cmdc0de/yet-another-processor/docs/compiler-rust/features.md

# Rust compiler features

Prefix: `COMPILER-RUST`

Higher-level language → YAP1. Output must run on `yap-emu`. Not LLVM. Not GCC. Not the Python assembler (`docs/compiler/`).

Implementation: `compiler/rust/`. Tests under `compiler/tests/` and/or that crate. v1 is **Linux**. Language shape and YAP1 layout are `design.md` after this catalog.

## Tree and host

| ID | Feature | Status | Milestone |
|----|---|---|---|
| COMPILER-RUST-001 | ~~Sources under `compiler/rust/`~~ | done | m1 |
| COMPILER-RUST-002 | ~~Build and tests run on Linux (dev host)~~ | done | m1 |
| COMPILER-RUST-003 | ~~Tests fail if `cargo` / `rustc` is missing~~ | done | m1 |

## Image and CLI

| ID | Feature | Status | Milestone |
|----|---|---|---|
| COMPILER-RUST-004 | ~~CLI: input path and `-o` YAP1 output~~ | done | m1 |
| COMPILER-RUST-005 | ~~Emits a valid YAP1 (same 16-byte header as the Python assembler)~~ | done | m1 |

## Language

| ID | Feature | Status | Milestone |
|----|---|---|---|
| COMPILER-RUST-006 | ~~Documented source language (`design.md`)~~ | done | m1 |
| COMPILER-RUST-007 | ~~Integer literals and add/sub in that language~~ | done | m2 |
| COMPILER-RUST-008 | ~~One entry function compiled to reset `PC=0` (or documented entry)~~ | done | m1 |
| COMPILER-RUST-009 | ~~Call/return using the ISA ABI (`sp`, `ra`, args)~~ | done | m2 |

## Run

| ID | Feature | Status | Milestone |
|----|---|---|---|
| COMPILER-RUST-010 | ~~A compiled program reaches `halt` on `yap-emu` (exit 0)~~ | done | m1 |

## Later generation (do not pull into m1)

| ID | Feature | Status | Milestone |
|----|---|---|---|
| COMPILER-RUST-011 | Multi-file programs / linking | open | later-generation |
| COMPILER-RUST-012 | C language frontend | open | later-generation |
| COMPILER-RUST-013 | Floating-point in the source language | open | later-generation |
