cmdc0de/yet-another-processor/docs/footprints-and-models/3d/IRLML6401TRPBF.step

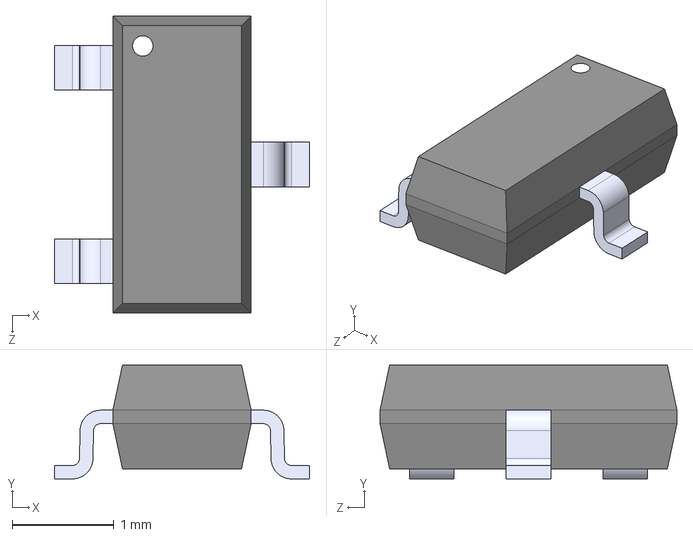
[picture p1: CAD file, 2025-11-29]
docs/footprints-and-models/3d/IRLML6401TRPBF.step
2.51 x 1.12 x 2.92 mm
