cmdc0de/yet-another-processor/docs/footprints-and-models/Fusion360/MICRO3_SOT23_INF.step

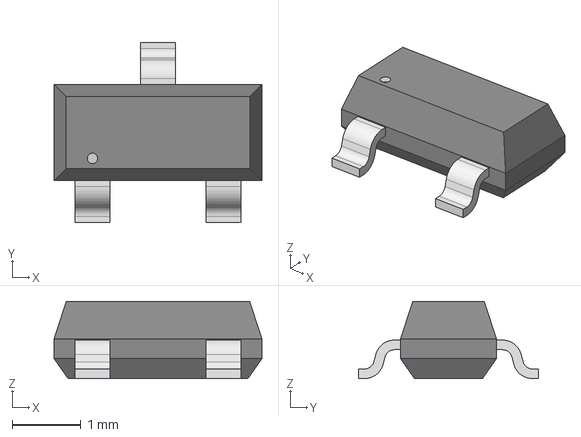
[picture p2: CAD file, 2025-11-29]
docs/footprints-and-models/Fusion360/MICRO3_SOT23_INF.step
3.02 x 2.62 x 1.12 mm
