cmdc0de/yet-another-processor/docs/footprints-and-models/3d/MAX4610CSD_T.step

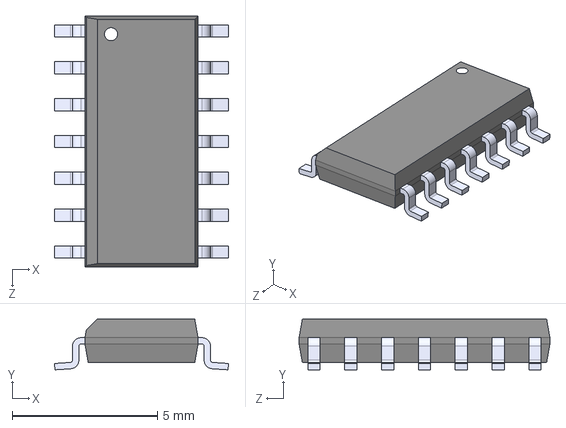
[picture p3: CAD file, 2025-11-29]
docs/footprints-and-models/3d/MAX4610CSD_T.step
6.00 x 1.75 x 8.65 mm
