cmdc0de/yet-another-processor/docs/physical-cpu/milestones/m11-testplan.md

# physical-cpu m11 testplan

One acceptance check per claimed feature. Walkthrough commands are written by `/implement-m`.

| ID | Check |
|----|---|
| PHYSICAL-CPU-016 | `hw/latch/` contains a `.kicad_pcb`. File text names `IRLML6246`, `IRLML6401`, `MICRO3_SOT23_INF`, and nets `D`, `EN`, `Q`, `VDD`, `VSS`. m1 latch tests still pass. |
