cmdc0de/yet-another-processor/lt-spice/and1_test.asc

U1: and1
V1: voltage; 3.3
V2: voltage; PULSE(0 3.3 45u 5u 5u 45u 100u 2)
V3: voltage; PULSE(0 3.3 95u 5u 5u 100u 200u 1)
Named nets: 0, vdd, a, b, and_out
.tran 200u
