cmdc0de/yet-another-processor/lt-spice/inverter_test.asc

V1: voltage; 3.3
V2: voltage; PULSE(0 3.3 50u 5u 5u 50u 100u 2)
X1: inverter; ""
Named nets: 0, in, out
.tran 200u
