cmdc0de/yet-another-processor/lt-spice/nand_test.asc

V1: voltage; 3.3
V2: voltage; PULSE(0 3.3 95u 5u 5u 100u 200u 2)
V3: voltage; PULSE(0 3.3 45u 5u 5u 45u 100u 2)
X1: nand
Named nets: 0, VDD, A, B, Y
.tran 200u
