cmdc0de/yet-another-processor/lt-spice/nor_test.asc

V1: voltage; 3.3
V2: voltage; PULSE(0 3.3 50u 5u 5u 50u 100u 2)
V3: voltage; PULSE(0 3.3 100u 5u 5u 100u 200u 1)
X1: nor
Named nets: 0, VDD, a, b, y
.inc ltspice_cmdc0de.lib
.tran 200u
