cmdc0de/yet-another-processor/hw/memport/memport_test.cir

YAP CPU memory port LAT_MEM=1 PHYSICAL-CPU-014
* Behavioral 32-bit word at addr 0. we+clk samples wdata; re drives rdata.
.subckt MEMBIT d we q vdd gnd
S1 d q we 0 icwe
Cq q 0 1n
Rq q 0 1T
.model icwe SW(vt=1.65 vh=0.4 ron=1 roff=1T)
.ends MEMBIT
VDD VDD 0 DC 3.3
VVSS VSS 0 DC 0
Vclk clk 0 PWL(0 0 50u 0 52u 3.3 80u 3.3 82u 0 150u 0)
Vwe we 0 PWL(0 3.3 80u 3.3 82u 0 150u 0)
Vre re 0 PWL(0 0 90u 0 92u 3.3 150u 3.3)
Vsz0 sz0 0 DC 0
Vsz1 sz1 0 DC 3.3
Vw0 wdata0 0 DC 3.3
Vw1 wdata1 0 DC 0
Vw2 wdata2 0 DC 0
Vw3 wdata3 0 DC 0
Vw4 wdata4 0 DC 0
Vw5 wdata5 0 DC 0
Vw6 wdata6 0 DC 0
Vw7 wdata7 0 DC 0
Vw8 wdata8 0 DC 0
Vw9 wdata9 0 DC 0
Vw10 wdata10 0 DC 0
Vw11 wdata11 0 DC 0
Vw12 wdata12 0 DC 0
Vw13 wdata13 0 DC 0
Vw14 wdata14 0 DC 0
Vw15 wdata15 0 DC 0
Vw16 wdata16 0 DC 0
Vw17 wdata17 0 DC 0
Vw18 wdata18 0 DC 0
Vw19 wdata19 0 DC 0
Vw20 wdata20 0 DC 0
Vw21 wdata21 0 DC 0
Vw22 wdata22 0 DC 0
Vw23 wdata23 0 DC 0
Vw24 wdata24 0 DC 0
Vw25 wdata25 0 DC 0
Vw26 wdata26 0 DC 0
Vw27 wdata27 0 DC 0
Vw28 wdata28 0 DC 0
Vw29 wdata29 0 DC 0
Vw30 wdata30 0 DC 0
Vw31 wdata31 0 DC 0
Va0 addr0 0 DC 0
Va1 addr1 0 DC 0
Va2 addr2 0 DC 0
Va3 addr3 0 DC 0
Va4 addr4 0 DC 0
Va5 addr5 0 DC 0
Va6 addr6 0 DC 0
Va7 addr7 0 DC 0
Va8 addr8 0 DC 0
Va9 addr9 0 DC 0
Va10 addr10 0 DC 0
Va11 addr11 0 DC 0
Va12 addr12 0 DC 0
Va13 addr13 0 DC 0
Va14 addr14 0 DC 0
Va15 addr15 0 DC 0
Va16 addr16 0 DC 0
Va17 addr17 0 DC 0
Va18 addr18 0 DC 0
Va19 addr19 0 DC 0
Va20 addr20 0 DC 0
Va21 addr21 0 DC 0
Va22 addr22 0 DC 0
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
Br30 rdata30 0 V={v(re)>1.65 ? v(m30) : 0}
Xm31 wdata31 weclk m31 VDD VSS MEMBIT
Br31 rdata31 0 V={v(re)>1.65 ? v(m31) : 0}
.ic v(m0)=0 v(m1)=0
.tran 1u 150u uic
.control
set filetype=ascii
run
meas tran r0 FIND v(rdata0) AT=120u
meas tran r1 FIND v(rdata1) AT=120u
.endc
.end
