cmdc0de/yet-another-processor/hw/ucode/ucode_test.cir

YAP microcode ROM 256x64 and uPC PHYSICAL-CPU-013
* Behavioral IC ROM + 8-bit uPC. seq=NEXT (0) increments. Not MOSFET storage.
.subckt UPCBIT d we q vdd gnd
S1 d q we 0 icwe
Cq q 0 10p
Rq q 0 1T
.model icwe SW(vt=1.65 vh=0.4 ron=1 roff=1T)
.ends UPCBIT
VDD VDD 0 DC 3.3
VVSS VSS 0 DC 0
Vclk clk 0 PWL(0 0 50u 0 52u 3.3 80u 3.3 82u 0 150u 0)
Bclkn clkn 0 V={v(clk)>1.65 ? 0 : 3.3}
Xm0 next0 clkn m0 VDD VSS UPCBIT
Cm0 m0 0 1n
Xs0 m0 clk upc0 VDD VSS UPCBIT
Xm1 next1 clkn m1 VDD VSS UPCBIT
Cm1 m1 0 1n
Xs1 m1 clk upc1 VDD VSS UPCBIT
Xm2 next2 clkn m2 VDD VSS UPCBIT
Cm2 m2 0 1n
Xs2 m2 clk upc2 VDD VSS UPCBIT
Xm3 next3 clkn m3 VDD VSS UPCBIT
Cm3 m3 0 1n
Xs3 m3 clk upc3 VDD VSS UPCBIT
Xm4 next4 clkn m4 VDD VSS UPCBIT
Cm4 m4 0 1n
Xs4 m4 clk upc4 VDD VSS UPCBIT
Xm5 next5 clkn m5 VDD VSS UPCBIT
Cm5 m5 0 1n
Xs5 m5 clk upc5 VDD VSS UPCBIT
Xm6 next6 clkn m6 VDD VSS UPCBIT
Cm6 m6 0 1n
Xs6 m6 clk upc6 VDD VSS UPCBIT
Xm7 next7 clkn m7 VDD VSS UPCBIT
Cm7 m7 0 1n
Xs7 m7 clk upc7 VDD VSS UPCBIT
Bisnxt isnxt 0 V={u(1.65-v(cw0))*u(1.65-v(cw1))*u(1.65-v(cw2))*3.3}
Bcin0 cin0 0 V=v(isnxt)
Bnext0 next0 0 V={(v(upc0)>1.65) ? ((v(cin0)>1.65) ? 0 : 3.3) : ((v(cin0)>1.65) ? 3.3 : 0)}
Bcin1 cin1 0 V={((v(upc0)>1.65) && (v(cin0)>1.65)) ? 3.3 : 0}
Bnext1 next1 0 V={(v(upc1)>1.65) ? ((v(cin1)>1.65) ? 0 : 3.3) : ((v(cin1)>1.65) ? 3.3 : 0)}
Bcin2 cin2 0 V={((v(upc1)>1.65) && (v(cin1)>1.65)) ? 3.3 : 0}
Bnext2 next2 0 V={(v(upc2)>1.65) ? ((v(cin2)>1.65) ? 0 : 3.3) : ((v(cin2)>1.65) ? 3.3 : 0)}
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
meas tran upc4c FIND v(upc4) AT=120u
meas tran upc5r FIND v(upc5) AT=20u
meas tran upc5c FIND v(upc5) AT=120u
meas tran upc6r FIND v(upc6) AT=20u
meas tran upc6c FIND v(upc6) AT=120u
meas tran upc7r FIND v(upc7) AT=20u
meas tran upc7c FIND v(upc7) AT=120u
.endc
.end
