cmdc0de/yet-another-processor/hw/reg32/reg32_test.cir

YAP 32-bit MOSFET register PHYSICAL-CPU-009
.include ../../lt-spice/yap_cells.lib
VDD VDD 0 DC 3.3
VVSS VSS 0 DC 0
Vwe WE 0 PWL(0 3.3 100u 3.3 102u 0 200u 0 202u 3.3 250u 3.3 252u 0 400u 0)
Vd0 d0 0 PWL(0 0 50u 0 52u 3.3 120u 3.3 122u 0 270u 0 272u 3.3 400u 3.3)
Vd1 d1 0 PWL(0 0 50u 0 52u 3.3 120u 3.3 122u 0 270u 0 272u 3.3 400u 3.3)
Vd2 d2 0 PWL(0 0 50u 0 52u 3.3 120u 3.3 122u 0 270u 0 272u 3.3 400u 3.3)
Vd3 d3 0 PWL(0 0 50u 0 52u 3.3 120u 3.3 122u 0 270u 0 272u 3.3 400u 3.3)
Vd4 d4 0 PWL(0 0 50u 0 52u 3.3 120u 3.3 122u 0 270u 0 272u 3.3 400u 3.3)
Vd5 d5 0 PWL(0 0 50u 0 52u 3.3 120u 3.3 122u 0 270u 0 272u 3.3 400u 3.3)
Vd6 d6 0 PWL(0 0 50u 0 52u 3.3 120u 3.3 122u 0 270u 0 272u 3.3 400u 3.3)
Vd7 d7 0 PWL(0 0 50u 0 52u 3.3 120u 3.3 122u 0 270u 0 272u 3.3 400u 3.3)
Vd8 d8 0 PWL(0 0 50u 0 52u 3.3 120u 3.3 122u 0 270u 0 272u 3.3 400u 3.3)
Vd9 d9 0 PWL(0 0 50u 0 52u 3.3 120u 3.3 122u 0 270u 0 272u 3.3 400u 3.3)
Vd10 d10 0 PWL(0 0 50u 0 52u 3.3 120u 3.3 122u 0 270u 0 272u 3.3 400u 3.3)
Vd11 d11 0 PWL(0 0 50u 0 52u 3.3 120u 3.3 122u 0 270u 0 272u 3.3 400u 3.3)
Vd12 d12 0 PWL(0 0 50u 0 52u 3.3 120u 3.3 122u 0 270u 0 272u 3.3 400u 3.3)
Vd13 d13 0 PWL(0 0 50u 0 52u 3.3 120u 3.3 122u 0 270u 0 272u 3.3 400u 3.3)
Vd14 d14 0 PWL(0 0 50u 0 52u 3.3 120u 3.3 122u 0 270u 0 272u 3.3 400u 3.3)
Vd15 d15 0 PWL(0 0 50u 0 52u 3.3 120u 3.3 122u 0 270u 0 272u 3.3 400u 3.3)
Vd16 d16 0 PWL(0 0 50u 0 52u 3.3 120u 3.3 122u 0 270u 0 272u 3.3 400u 3.3)
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
meas tran q29hold1 FIND v(q29) AT=180u
meas tran q30follow0 FIND v(q30) AT=40u
meas tran q30follow1 FIND v(q30) AT=90u
meas tran q30hold1 FIND v(q30) AT=180u
meas tran q31follow0 FIND v(q31) AT=40u
meas tran q31follow1 FIND v(q31) AT=90u
meas tran q31hold1 FIND v(q31) AT=180u
.endc
.end
