cmdc0de/yet-another-processor/hw/adder32/adder32_test.cir

YAP 32-bit ripple adder PHYSICAL-CPU-008
.include ../../lt-spice/yap_cells.lib
VDD VDD 0 DC 3.3
VVSS VSS 0 DC 0
Vcin cin 0 DC 0
Va0 a0 0 DC 0
Vb0 b0 0 DC 0
Va1 a1 0 DC 0
Vb1 b1 0 DC 0
Va2 a2 0 DC 0
Vb2 b2 0 DC 0
Va3 a3 0 DC 0
Vb3 b3 0 DC 0
Va4 a4 0 DC 0
Vb4 b4 0 DC 0
Va5 a5 0 DC 0
Vb5 b5 0 DC 0
Va6 a6 0 DC 0
Vb6 b6 0 DC 0
Va7 a7 0 DC 0
Vb7 b7 0 DC 0
Va8 a8 0 DC 0
Vb8 b8 0 DC 0
Va9 a9 0 DC 0
Vb9 b9 0 DC 0
Va10 a10 0 DC 0
Vb10 b10 0 DC 0
Va11 a11 0 DC 0
Vb11 b11 0 DC 0
Va12 a12 0 DC 0
Vb12 b12 0 DC 0
Va13 a13 0 DC 0
Vb13 b13 0 DC 0
Va14 a14 0 DC 0
Vb14 b14 0 DC 0
Va15 a15 0 DC 0
Vb15 b15 0 DC 0
Va16 a16 0 DC 0
Vb16 b16 0 DC 0
Va17 a17 0 DC 0
Vb17 b17 0 DC 0
Va18 a18 0 DC 0
Vb18 b18 0 DC 0
Va19 a19 0 DC 0
Vb19 b19 0 DC 0
Va20 a20 0 DC 0
Vb20 b20 0 DC 0
Va21 a21 0 DC 0
Vb21 b21 0 DC 0
Va22 a22 0 DC 0
Vb22 b22 0 DC 0
Va23 a23 0 DC 0
Vb23 b23 0 DC 0
Va24 a24 0 DC 0
Vb24 b24 0 DC 0
Va25 a25 0 DC 0
Vb25 b25 0 DC 0
Va26 a26 0 DC 0
Vb26 b26 0 DC 0
Va27 a27 0 DC 0
Vb27 b27 0 DC 0
Va28 a28 0 DC 0
Vb28 b28 0 DC 0
Va29 a29 0 DC 0
Vb29 b29 0 DC 0
Va30 a30 0 DC 0
Vb30 b30 0 DC 0
Va31 a31 0 DC 0
Vb31 b31 0 DC 0
X0 a0 b0 cin sum0 c0 VDD VSS ADDER
X1 a1 b1 c0 sum1 c1 VDD VSS ADDER
X2 a2 b2 c1 sum2 c2 VDD VSS ADDER
X3 a3 b3 c2 sum3 c3 VDD VSS ADDER
X4 a4 b4 c3 sum4 c4 VDD VSS ADDER
X5 a5 b5 c4 sum5 c5 VDD VSS ADDER
X6 a6 b6 c5 sum6 c6 VDD VSS ADDER
X7 a7 b7 c6 sum7 c7 VDD VSS ADDER
X8 a8 b8 c7 sum8 c8 VDD VSS ADDER
X9 a9 b9 c8 sum9 c9 VDD VSS ADDER
X10 a10 b10 c9 sum10 c10 VDD VSS ADDER
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
.endc
.end
