cmdc0de/yet-another-processor/lt-spice/inverter_raw.asc

M1: nmos; IRLML6246
M2: pmos; IRLML6401
V1: voltage; 3.3
V2: voltage; PULSE(0 3.3 50u 5u 5u 50u 100u 2)
Named nets: 0, out, in
.inc ltspice_cmdc0de.lib
.tran 200u
