cmdc0de/yet-another-processor/lt-spice/xor_tg_raw.asc

M1: pmos; IRLML6401
M2: pmos; IRLML6401
M3: nmos; IRLML6246
M4: nmos; IRLML6246
V1: voltage; 3.3
V2: voltage; PULSE(0 3.3 50u 5u 5u 50u 100u 2)
V3: voltage; PULSE(0 3.3 100u 5u 5u 100u 200u 1)
X1: inverter
X2: inverter
Named nets: a, na, 0, b, nb, vdd, y
.tran 200u
3 pin mosfets really don't work bc of something to do with the 
max output on the gate to source is Vgs - Vth = I think...
