cmdc0de/yet-another-processor/lt-spice/xor_tg_raw5.asc

U2: MAX4610
V1: voltage; 3.3
V2: voltage; PULSE(0 3.3 50u 5u 5u 50u 100u 2)
V3: voltage; PULSE(0 3.3 100u 5u 5u 100u 200u 1)
X1: inverter
X2: inverter
Named nets: a, na, 0, b, nb, vdd, out
.inc ltspice_cmdc0de.lib
.tran 200u
works with Normally open switch and no need for inverter like the normally closed one
