cmdc0de/yet-another-processor/lt-spice/1-bit-full-adder.asc

U1: xor_max4610
U2: xor_max4610
U3: and1; ""
U4: and1; ""
U5: or1; ""
V1: voltage; 3.3
V2: voltage; PWL(0 0 10u 0 10.001u 3.3 20u 3.3 20.001u 0 30u 0 30.001u 3.3 40u 3.3 40.001u 0 50u 0 50.001u 3.3 60u 3.3 60.001u 0 70u 0 70.001u 3.3 80u 3.3)
V3: voltage; PWL(0 0 20u 0 20.001u 3.3 40u 3.3 40.001u 0 60u 0 60.001u 3.3 80u 3.3)
V4: voltage; PWL(0 0 40u 0 40.001u 3.3 80u 3.3)
Named nets: X1, a, b, vdd, 0, Cin, Sum, ab, cx1, Cout
.tran 80u
