cmdc0de/yet-another-processor/lt-spice/tg_raw.asc

M1: nmos4; SST210
M2: pmos4; SST214
V1: voltage; 3.3
V2: voltage; PULSE(0 3.3 100u 5u 5u 100u 200u 1)
V3: voltage; PULSE(0 3.3 50u 5u 5u 50u 100u 2)
V4: voltage; PWL(0u 3.3 50u 3.3 55u 0 100u 0 105u 3.3 150u 3.3 155u 0)
Named nets: 0, out, in, ctrln, ctrl
.inc ltspice_cmdc0de.lib
.tran 200u
