cmdc0de/yet-another-processor/hw/latch/latch.kicad_pcb

## KiCad design hw/latch/latch.kicad_pcb (2026-09-29)

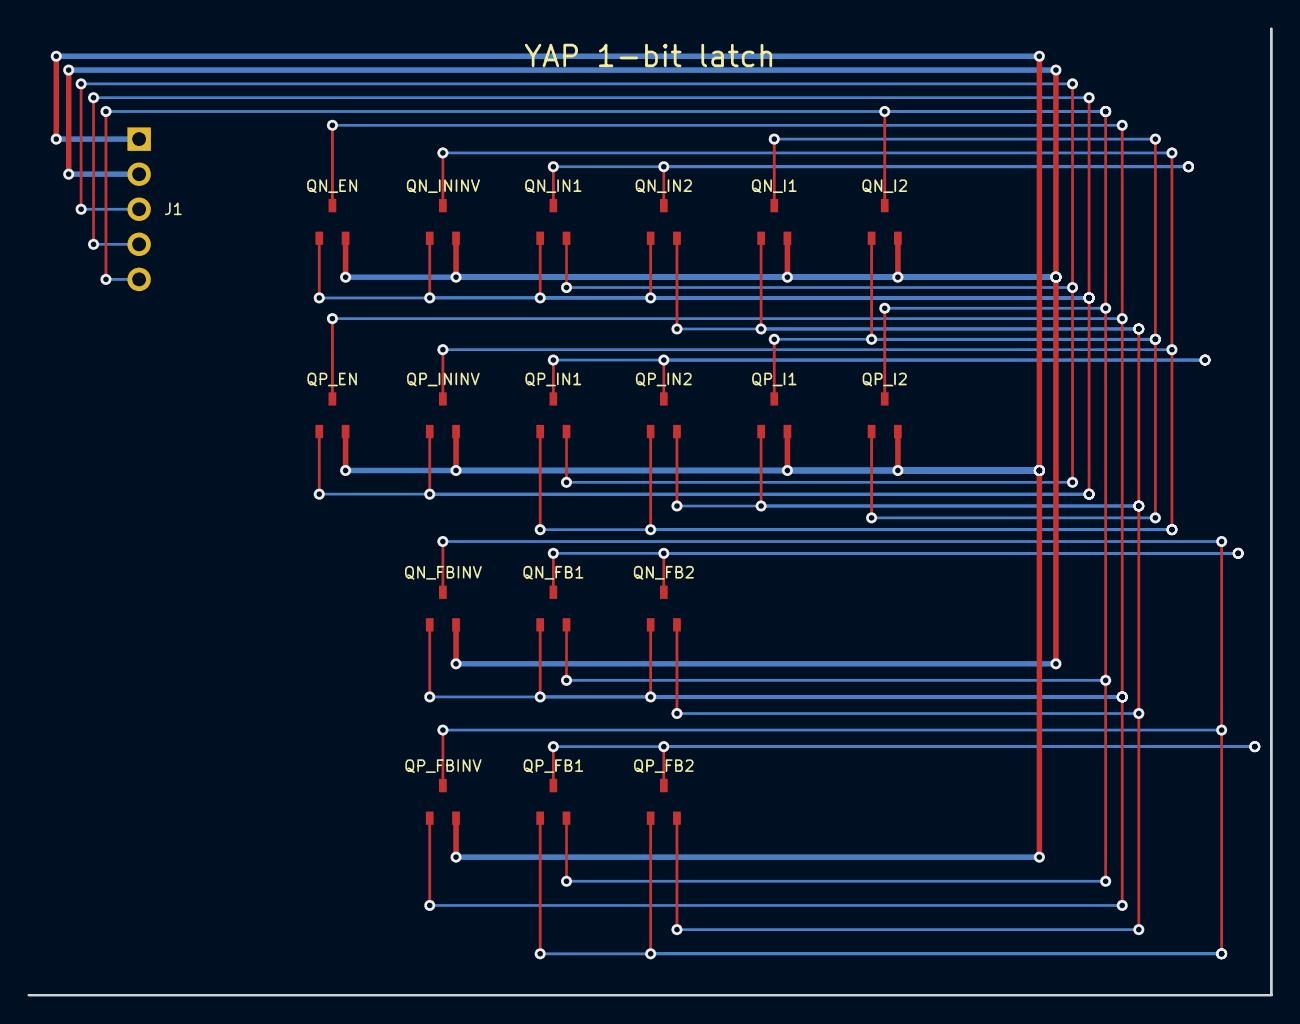
[picture p4: board latch.kicad_pcb from above]

Board: 2 copper layers, 90.0 x 70.0 mm, 19 parts (0 on the bottom side), 14 nets.

Parts:
J1: HDR_2.54_1x05; PinHeader_1x05_P2.54mm
QN_EN: IRLML6246; MICRO3_SOT23_INF
QN_FB1, QN_FB2: IRLML6246; MICRO3_SOT23_INF
QN_FBINV: IRLML6246; MICRO3_SOT23_INF
QN_I1, QN_I2: IRLML6246; MICRO3_SOT23_INF
QN_IN1, QN_IN2: IRLML6246; MICRO3_SOT23_INF
QN_ININV: IRLML6246; MICRO3_SOT23_INF
QP_EN: IRLML6401; MICRO3_SOT23_INF
QP_FB1, QP_FB2: IRLML6401; MICRO3_SOT23_INF
QP_FBINV: IRLML6401; MICRO3_SOT23_INF
QP_I1, QP_I2: IRLML6401; MICRO3_SOT23_INF
QP_IN1, QP_IN2: IRLML6401; MICRO3_SOT23_INF
QP_ININV: IRLML6401; MICRO3_SOT23_INF

Connections:
D: J1.3, QN_IN1.2, QP_IN1.2
EN: J1.4, QN_EN.1, QN_IN1.1, QN_IN2.1, QN_ININV.1, QP_EN.1, QP_ININV.1
ENB: QN_EN.3, QN_FB1.1, QN_FB2.1, QN_FBINV.1, QP_EN.3, QP_FBINV.1
ENB_FB: QN_FBINV.3, QP_FB1.1, QP_FB2.1, QP_FBINV.3
ENB_IN: QN_ININV.3, QP_IN1.1, QP_IN2.1, QP_ININV.3
MIDN_FB: QN_FB1.3, QN_FB2.3
MIDN_IN: QN_IN1.3, QN_IN2.3
MIDP_FB: QP_FB1.3, QP_FB2.3
MIDP_IN: QP_IN1.3, QP_IN2.3
N1: QN_FB2.2, QN_I1.1, QN_IN2.2, QP_FB2.2, QP_I1.1, QP_IN2.2
Q: J1.5, QN_FB1.2, QN_I2.3, QP_FB1.2, QP_I2.3
QB: QN_I1.3, QN_I2.1, QP_I1.3, QP_I2.1
VDD: J1.1, QP_EN.2, QP_FBINV.2, QP_I1.2, QP_I2.2, QP_ININV.2
VSS: J1.2, QN_EN.2, QN_FBINV.2, QN_I1.2, QN_I2.2, QN_ININV.2
