cmdc0de/yet-another-processor/(commit log)

2025-11-29 Ok switched all mosfets to be IRML6246 n channel and IRML4601 for p channel and switched to max 4610CSD part since I'll be using NO switches
    [IRLML6246TRPBF.step, IRLML6401TRPBF.step, MAX4610CSD_T.step, MICRO3_SOT23_INF.step]
2025-11-29 line ending .....
    [IRLML6246TRPBF.step, IRLML6401TRPBF.step, MAX4610CSD_T.step, MICRO3_SOT23_INF.step]
2026-09-16 Rewrite project-goals.md with locked system goals.
    Replace the sketch with the agreed 32-bit computer description, MOSFET/IC split, non-goals, subprojects, and sequencing.
2026-09-16 Add isa design: 32-bit LE encodings, base/limit, ABI.
    Freeze MIPS-shaped formats, wired r0-r2, flags, traps at 0x80, and v1 one-window user protection.
2026-09-16 Implement isa m1: Python ISA module, ALU, CMP/TEST/TEQ.
    Add compiler/yap_isa pack/unpack and a behavioral step for wired r0-r2, flags, and m1 SPECIAL ops, plus unittest coverage and walkthrough.
2026-09-17 Implement isa m3: DIV, load/store, j/jal/jr/jalr.
    Add little-endian memory, unsigned divide, and jumps without delay slots. Alignment faults set CAUSE=8.
2026-09-17 Implement isa m4: flag branches and HALT.
    Add B-type bcc mnemonics (beq/bne/blo/...) and halt; taken branches replace PC+4 with no delay slot.
2026-09-17 Add isa m5 plan: privilege, traps, sys, reserved VM bits.
    Claim ISA-033–042 and ISA-049. Setting TE traps. COP1 and ABI stack stay open.
2026-09-17 Add isa m6 plan: COP1 moves and ABI stack map.
    Claim ISA-043–048. No FP arithmetic. ISA-051 stays later-generation.
2026-09-17 Add assembler catalog and YAP1 design.
    Lock 16-byte YAP1 header (magic, load, size, entry) plus source syntax; payload is raw LE at load address.
2026-09-17 Add assembler m1 plan: YAP1 CLI without labels.
    Claim 10 features for file assemble, header, comments, and line errors.
2026-09-17 Implement assembler m1: YAP1 CLI without labels.
    Add header pack/unpack and python3 -m compiler.asm for instruction-only sources.
2026-09-17 Mark assembler m1 features done.
    Walkthrough passed; YAP1 CLI rows stay struck and stay attributed to m1.
2026-09-17 Add assembler m2 plan: labels, forward refs, .org.
    Claim COMPILER-008–011. Data directives and --run stay open.
2026-09-17 Implement assembler m2: labels, forward refs, .org.
    Two-pass assemble with zero-fill gaps; m1 tests still pass.
2026-09-17 Mark assembler m2 features done.
    Walkthrough passed; labels, forward refs, and .org stay struck and stay attributed to m2.
2026-09-17 Add assembler m3 plan: .byte/.half/.word, .align, .equ.
    Claim COMPILER-012–014. Pseudos and --run stay open.
2026-09-17 Implement assembler m3: .byte/.half/.word, .align, .equ.
    Data emit with alignment checks; .equ substitutes in immediates and off(rs).
2026-09-17 Mark assembler m3 features done.
    Walkthrough passed; data directives stay struck and stay attributed to m3.
2026-09-17 Add assembler m4 plan: li/move/la and --run.
    Claim COMPILER-015–017 and COMPILER-020. Finishes v1 assembler except later-generation rows.
2026-09-17 Implement assembler m4: li/move/la and --run.
2026-09-17 Mark assembler m4 features done.
2026-09-19 Add cpu catalog rows for jump and branch (CPU-039–043)
2026-09-20 Add mosfet-cells feature catalog
2026-09-20 Add mosfet-cells design: IRLML6246/6401, ngspice, 3.3 V levels
2026-09-20 Add physical-cpu design: KiCad 6, ngspice, latch ports
2026-09-20 Implement physical-cpu m1: hw latch slice, ngspice hold
    [latch.kicad_sch]
2026-09-20 Implement physical-cpu m2: flags bit, 1-bit adder
    [adder.kicad_sch, flags.kicad_sch]
2026-09-20 Implement physical-cpu m3: 32-bit ripple adder
    [adder32.kicad_sch]
2026-09-20 Add physical-cpu m4 plan: 32-bit MOSFET register
2026-09-20 Implement physical-cpu m4: 32-bit MOSFET register
    [reg32.kicad_sch]
2026-09-20 Add physical-cpu m5 plan: wired r0 r1 r2 constants
2026-09-20 Implement physical-cpu m5: wired r0 r1 r2 constants
    [wired.kicad_sch]
2026-09-20 Add physical-cpu m6 plan: MOSFET GPR bank r3-r15
2026-09-20 Implement physical-cpu m6: MOSFET GPR bank r3-r15
    [rf_mosfet.kicad_sch]
2026-09-20 Implement physical-cpu m7: IC GPR bank r16-r31
    [rf_ic.kicad_sch]
2026-09-20 Implement physical-cpu m8: microcode ROM and uPC
    [ucode.kicad_sch]
2026-09-20 Implement physical-cpu m9: CPU memory port
    [memport.kicad_sch]
2026-09-20 Add physical-cpu m10 plan: MOSFET ALU add/sub/logic
2026-09-20 Implement physical-cpu m10: MOSFET ALU add/sub/logic
    [alu.kicad_sch]
2026-09-20 Add memory-bus design: 3.3 V tristate SRAM protocol
2026-09-21 Implement mcu m1: poll MMIO port, idle after reset
    [mcu.v, tb.v]
2026-09-22 Add power feature catalog
2026-09-22 Add power design: VIN 5 V, REG33 to VDD 3.3 V
2026-09-22 Add power m1 plan: REG33 VIN 5 V to VDD 3.3 V
2026-09-22 Implement power m1: REG33 VIN 5 V to VDD 3.3 V
2026-09-22 Mark power m1 features done
2026-09-22 Implement fpu m1: COP1 file, binary32, reset zeros
    [fpu.v, tb.v]
2026-09-27 Add fpu m3 plan: assembler encodings, kernel FP save/restore
2026-09-27 Implement fpu m3: assembler encodings, kernel FP save/restore
2026-09-27 Add power m2 plan: AP2112M-3.3TRG1 named LDO
2026-09-27 Implement power m2: AP2112M-3.3TRG1 named LDO
    [ldo.kicad_sch]
2026-09-27 Mark power m2 features done
2026-09-27 Add power m3 plan: AP2112 EN on/off
2026-09-27 Implement power m3: AP2112 EN on/off
2026-09-27 Mark power m3 features done
2026-09-27 Add power m4 plan: 5 V I/O level shifter
2026-09-27 Implement power m4: 5 V I/O level shifter
2026-09-27 Mark power m4 features done
2026-09-27 Add physical-cpu m11 plan: 1-bit latch PCB
2026-09-27 Implement physical-cpu m11: 1-bit latch PCB
    [latch.kicad_pcb]
2026-09-27 Add physical-cpu m12 plan: latch assemble and bench
2026-09-27 Add physical-cpu m12 BOM and bring-up notes
2026-09-29 Route physical-cpu m12 latch PCB and add assembly table
    Pads that share a net are tied by copper. assembly.md is the MOSFET pin map.
    [latch.kicad_pcb]
